Daru-Mau/ILMModule/Robotics & Design_ Localization module anthology/cover.tex

\begin{titlepage}
   \begin{center}
       
       % Logo centrale
       \begin{figure}[h]
       \begin{center}
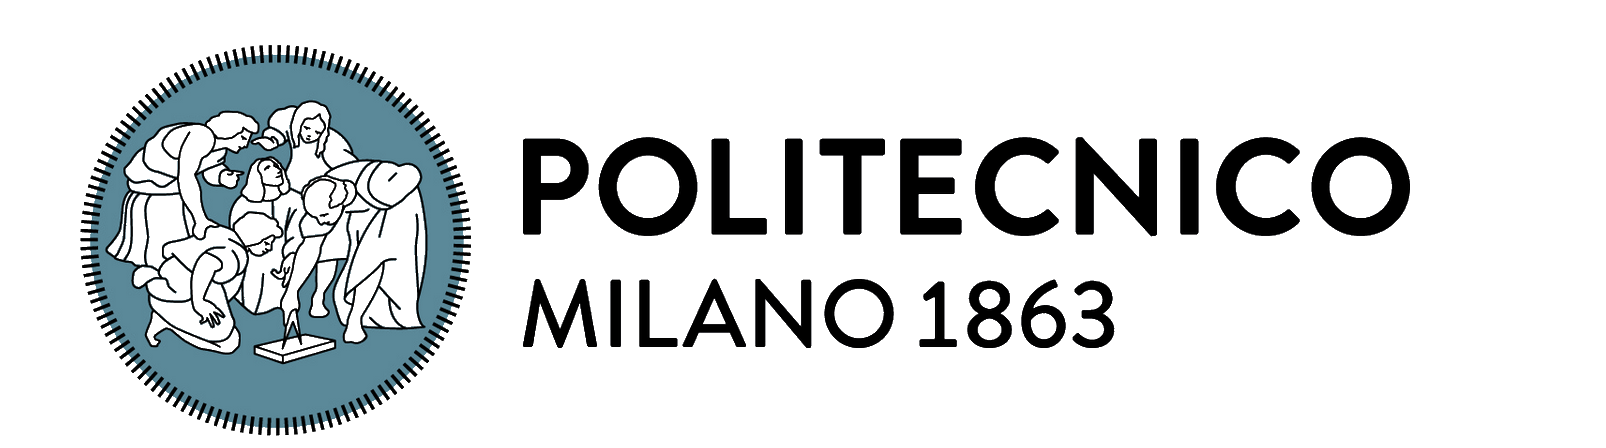
[picture p31: Robotics & Design_ Localization module anthology/photos/polimiLogo.png]
           
       \end{center}
       \end{figure}

       \vspace{0.5cm}
       
       {\large Interdisciplinary course of}
       
       \vspace{0.3cm}
       
       {\LARGE \textbf{Design and Robotics}}
       
       \vspace{0.3cm}
       
       {\large XIII° edition, 2025}
       
       \vspace{1.5cm}
       
       {\large Project:}
       
       \vspace{0.3cm}
       
       {\LARGE \textbf{Movement and Localization Module}}
       
       \vspace{2cm}
       
       % Professors and Tutors
       \begin{flushleft}
           {\large \textbf{Professors:}} \\
           Andrea Bonarini, DEIB department, Politecnico di Milano \\
           Maximiliano Romero, Design department, Politecnico di Milano \\
           \vspace{0.5cm}
           {\large \textbf{Tutors:}} \\
           Federico Espositi, Samuele Mengarelli, Niccolò Maria Oliva, Rohan Vangal \\
           \vspace{0.5cm}
           {\large \textbf{Group name/code:}} Movement and Localization \\
       \end{flushleft}
       
       \vspace{1cm}
       
       % Students
       \begin{flushleft}
           {\large \textbf{Students:}} \\
           Ermelinda Giulivo, School of Computer Science and Engineering \\
           Rafael Monllor Ballesteros, School of Industrial and Information Engineering \\
           Daniel Mauricio Ruiz Suarez, School of Computer Science and Engineering \\
           Jurij Diego Scandola, School of Computer Science and Engineering \\
           Abdul Moiz, School of Design and Industrial Engineering \\
           \vspace{1cm}
           \textbf{Academic Year:} 2024 - 2025 \\
       \end{flushleft}
   \end{center}

\end{titlepage}
