Daru-Mau/ILMModule/Robotics & Design_ Localization module anthology/main.tex

\documentclass{article}
\usepackage[utf8]{inputenc}
\usepackage{graphicx} 
\usepackage{import}
\usepackage{imakeidx} 
\usepackage{amsmath}
\usepackage{amssymb}
\usepackage{pdfpages}
\usepackage{array}
\usepackage{float} 
\usepackage{multicol}
\usepackage{listings} 
\usepackage{url}
\usepackage{csquotes}
\usepackage{caption}
\usepackage{xcolor}   
\usepackage{geometry}

\geometry{top=25mm, bottom=25mm, left=20mm, right=20mm}
\setlength{\parindent}{0pt}
\renewcommand\contentsname{Index}

\begin{document}

\import{./}{cover.tex}
\tableofcontents

% Abstract
\input{sections/abstract}

% Phase 1: Discover
\input{sections/phase1_discover}
\input{sections/movement_approach}
\input{sections/wheel_configurations}
\input{sections/robot_shape}
\input{sections/sensing_technology}

% Phase 2: Define
\input{sections/phase2_define}
\input{sections/strategy}
\input{sections/functionalities}
\input{sections/electronics}
\input{sections/coding}
\input{sections/structure}
\input{sections/shape}
\input{sections/concept}

% Phase 3: Develop
\input{sections/phase3_develop}
\input{sections/phase3_strategy}
\input{sections/phase3_electronics}
\input{sections/phase3_coding}
\input{sections/phase3_structure}
\input{sections/phase3_shape}

% Phase 4: Deliver
\input{sections/phase4_deliver}
\input{sections/phase4_robot_description}
\input{sections/phase4_strategy}
\input{sections/phase4_shape}
\input{sections/phase4_mechanics}
\input{sections/phase4_electronics}
\input{sections/phase4_informatics}

% Conclusion
\input{sections/conclusion}

% Appendix
\input{sections/appendix}

% Minutes of the Meetings
\input{sections/minutes}

% Bibliography
\input{sections/bibliography}

\end{document}
