Daru-Mau/ILMModule/Robotics & Design_ Localization module anthology/sections/phase3_develop.tex

\section{Phase 3: Develop}

In this phase we describe the development process, departing from the first prototype to the final improvements regarding strategy, electronics, coding, structure, and shape.
