Daru-Mau/ILMModule/Robotics & Design_ Localization module anthology/sections/prototypes.tex

\subsection{Group Cardboard Prototype Proposals}

When tasked with creating a cardboard prototype of the module, the group presented four different design proposals.

\subsubsection{Omnidirectional robot with four wheels positioned at the vertices of a square}
\textit{Proposed by: Ermelinda Giulivo}

\begin{figure}[H]
    \centering
    
    \caption{Four-wheel square configuration prototype}
\end{figure}

\subsubsection{Triangular-shaped, three-wheel omnidirectional robot}
\textit{Proposed by: Rafael Monllor Ballesteros}

\begin{figure}[H]
    \centering
    
    \caption{Triangular three-wheel configuration prototype}
\end{figure}

\subsubsection{Polygonal-shaped omnidirectional robot with four wheels arranged in a cross configuration}
\textit{Proposed by: Daniel Mauricio Ruiz Suarez}

\begin{figure}[H]
    \centering
    
    \caption{Polygonal cross-wheel configuration prototype}
\end{figure}

\subsubsection{Circular-shaped, three-wheel omnidirectional robot}
\textit{Proposed by: Jurij Diego Scandola}

\begin{figure}[H]
    \centering
    
    \caption{Circular three-wheel configuration prototype}
\end{figure}
