Daru-Mau/ILMModule/Robotics & Design_ Localization module anthology/sections/minutes.tex

\section{Minutes of the Meetings}

\subsection{Meeting: Project Kickoff}
\textbf{Date:} March 10, 2025\\
\textbf{Venue:} Politecnico di Milano, Bovisa Campus, Building B12, Room 5.1\\
\textbf{Attendees:} Ermelinda Giulivo, Rafael Monllor Ballesteros, Daniel Mauricio Ruiz Suarez, Jurij Diego Scandola, Abdul Moiz

\textbf{Topics Discussed:}
\begin{itemize}
    \item Introduction to project requirements and goals
    \item Team role assignments and responsibility distribution
    \item Initial brainstorming on robot concept and functionality
    \item Discussion of project timeline and key milestones
\end{itemize}

\textbf{Decisions:}
\begin{itemize}
    \item Selected Jurij Diego Scandola as team leader and backbone member
    \item Assigned specific roles to each team member
    \item Agreed to focus on an omnidirectional movement system
    \item Established weekly meeting schedule for progress updates
\end{itemize}

\subsection{Meeting: Design Phase Review}
\textbf{Date:} March 17, 2025\\
\textbf{Venue:} Virtual Meeting (Video Conference)\\
\textbf{Attendees:} Ermelinda Giulivo, Rafael Monllor Ballesteros, Daniel Mauricio Ruiz Suarez, Jurij Diego Scandola, Abdul Moiz

\textbf{Topics Discussed:}
\begin{itemize}
    \item Review of initial research findings
    \item Presentation and evaluation of different wheel configuration options
    \item Comparison of sensor technologies for obstacle detection
    \item Discussion of aesthetic concepts and physical form
\end{itemize}

\textbf{Decisions:}
\begin{itemize}
    \item Selected three-wheel omnidirectional configuration
    \item Chose ultrasonic sensors as primary obstacle detection method
    \item Approved "cooking pot" aesthetic concept with cloud-like base
    \item Assigned team members to begin component procurement
\end{itemize}

\subsection{Meeting: Development Phase Coordination}
\textbf{Date:} April 7, 2025\\
\textbf{Venue:} Politecnico di Milano, Bovisa Campus, Prototyping Lab\\
\textbf{Attendees:} Ermelinda Giulivo, Rafael Monllor Ballesteros, Daniel Mauricio Ruiz Suarez, Jurij Diego Scandola, Abdul Moiz

\textbf{Topics Discussed:}
\begin{itemize}
    \item Progress update on physical structure construction
    \item Review of electronics configuration and wiring plan
    \item Discussion of software architecture and control algorithms
    \item Timeline adjustment for remaining development tasks
\end{itemize}

\textbf{Decisions:}
\begin{itemize}
    \item Modified structural design to remove intermediate platform
    \item Approved motor driver selection and power distribution approach
    \item Established coding standards and module interfaces
    \item Adjusted timeline to allow more time for integration testing
\end{itemize}

\subsection{Meeting: Final Integration and Testing}
\textbf{Date:} May 12, 2025\\
\textbf{Venue:} Politecnico di Milano, Bovisa Campus, Robotics Lab\\
\textbf{Attendees:} Ermelinda Giulivo, Rafael Monllor Ballesteros, Daniel Mauricio Ruiz Suarez, Jurij Diego Scandola, Abdul Moiz

\textbf{Topics Discussed:}
\begin{itemize}
    \item Integration status of all subsystems
    \item Test results and performance metrics
    \item Remaining issues and troubleshooting
    \item Final presentation preparation
\end{itemize}

\textbf{Decisions:}
\begin{itemize}
    \item Implemented additional stabilization code for smoother movement
    \item Added LED lighting effects to enhance visual appeal
    \item Assigned final documentation responsibilities
    \item Scheduled rehearsal for final presentation
\end{itemize}

\subsection{Meeting: Project Wrap-up}
\textbf{Date:} May 29, 2025\\
\textbf{Venue:} Virtual Meeting (Video Conference)\\
\textbf{Attendees:} Ermelinda Giulivo, Rafael Monllor Ballesteros, Daniel Mauricio Ruiz Suarez, Jurij Diego Scandola, Abdul Moiz

\textbf{Topics Discussed:}
\begin{itemize}
    \item Final project status and demonstration readiness
    \item Report completion and review
    \item Lessons learned and project retrospective
    \item Future improvement possibilities
\end{itemize}

\textbf{Decisions:}
\begin{itemize}
    \item Finalized demonstration script and responsibility assignments
    \item Approved final report for submission
    \item Agreed on project archiving process for documentation and code
    \item Discussed potential extensions for future project iterations
\end{itemize}
