Daru-Mau/ILMModule/Robotics & Design_ Localization module anthology/photos/2.jpg

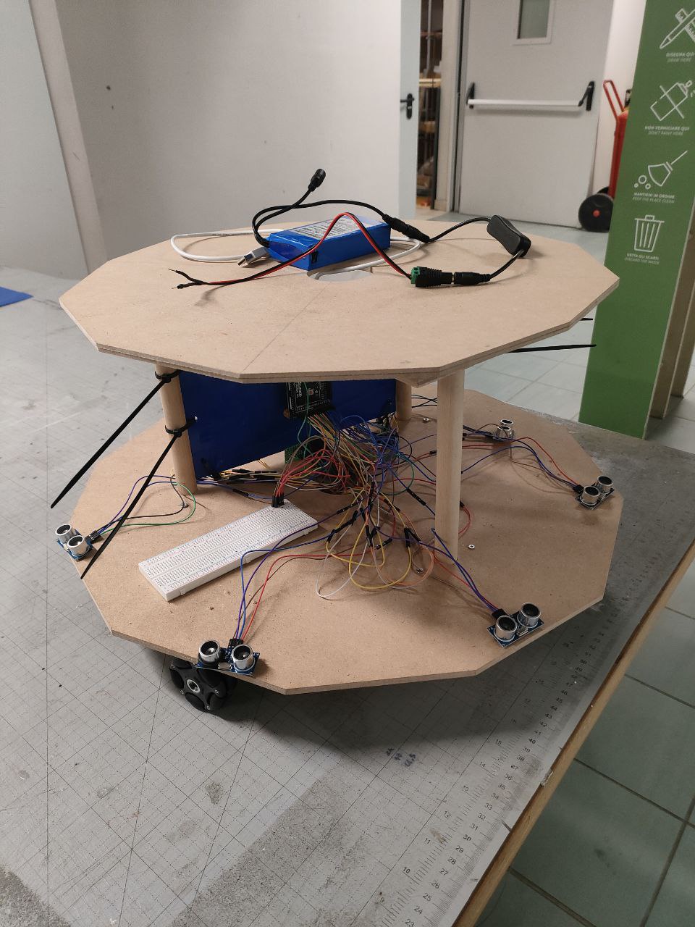
Robotics & Design_ Localization module anthology/photos/2.jpg
