Daru-Mau/ILMModule/Robotics & Design_ Localization module anthology/photos/4.jpg

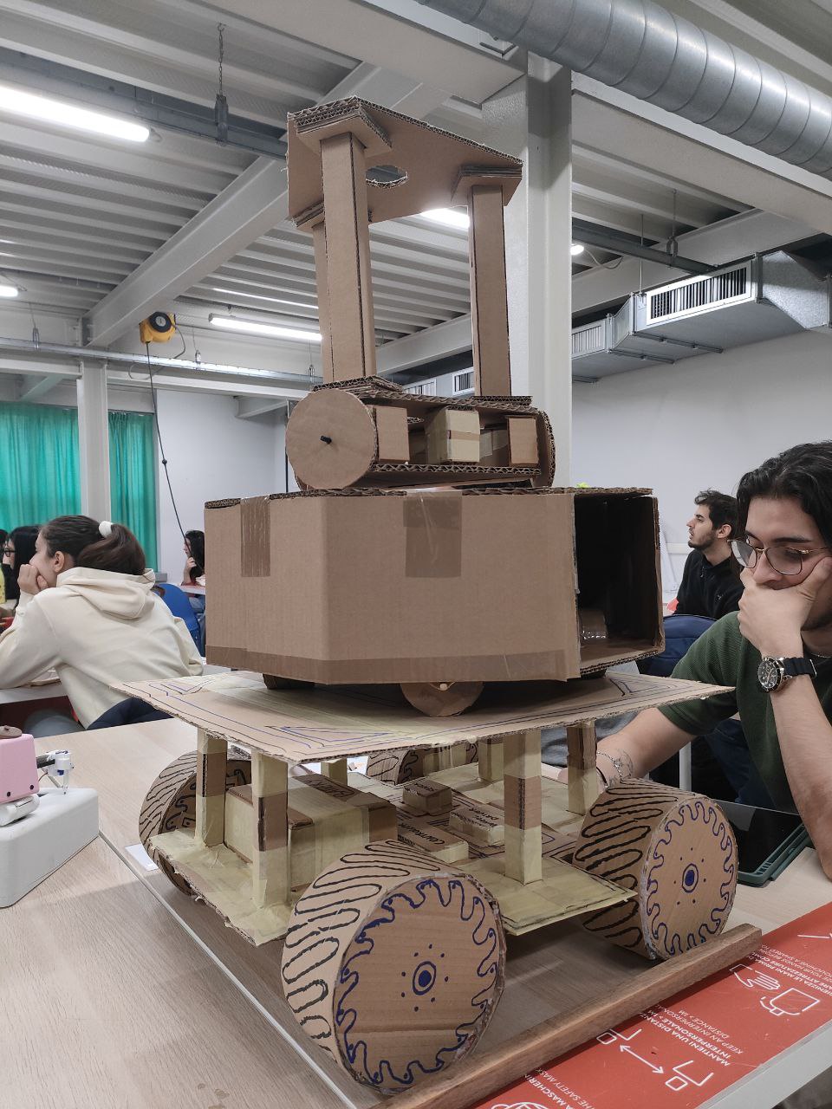
Robotics & Design_ Localization module anthology/photos/4.jpg
