Daru-Mau/ILMModule/Robotics & Design_ Localization module anthology/photos/5.jpg

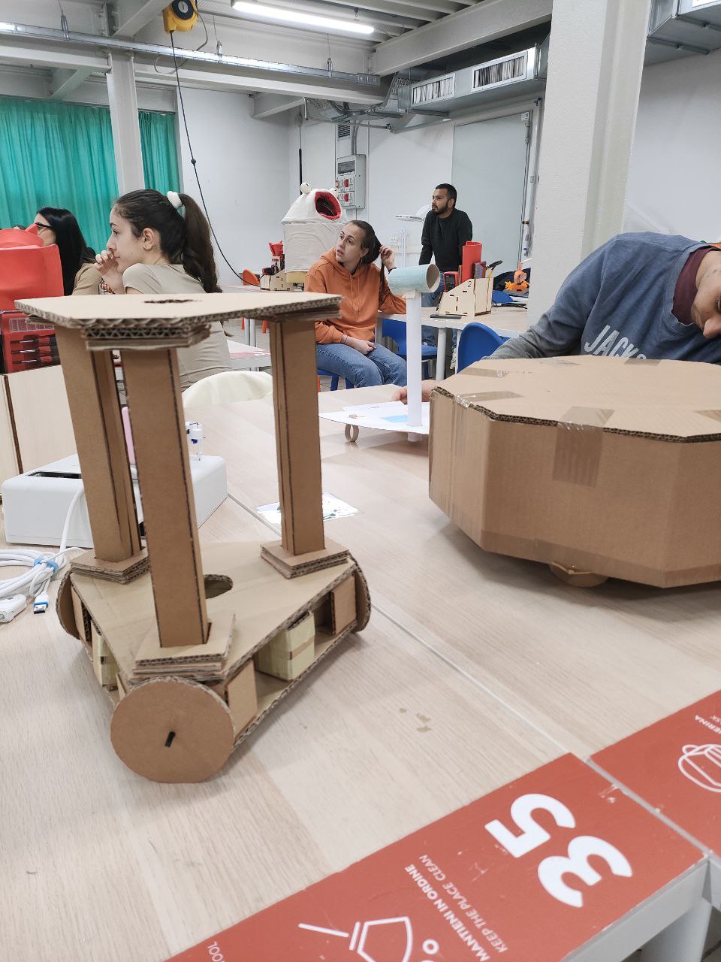
Robotics & Design_ Localization module anthology/photos/5.jpg
