Daru-Mau/ILMModule/Robotics & Design_ Localization module anthology/photos/6.jpg

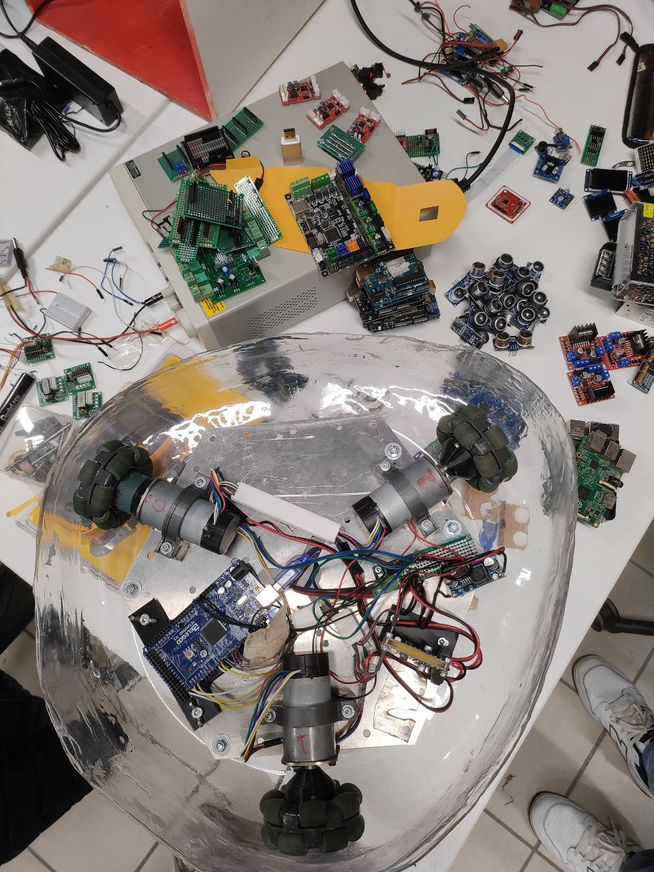
Robotics & Design_ Localization module anthology/photos/6.jpg
