Daru-Mau/ILMModule/Robotics & Design_ Localization module anthology/photos/8.jpg

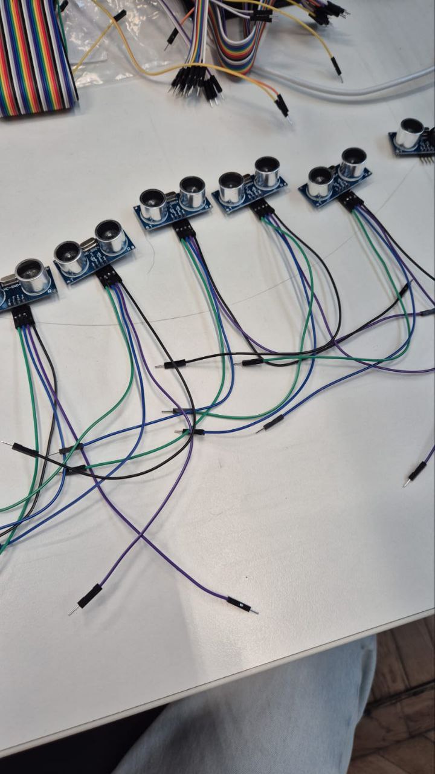
Robotics & Design_ Localization module anthology/photos/8.jpg
