Daru-Mau/ILMModule/Robotics & Design_ Localization module anthology/photos/10.jpg

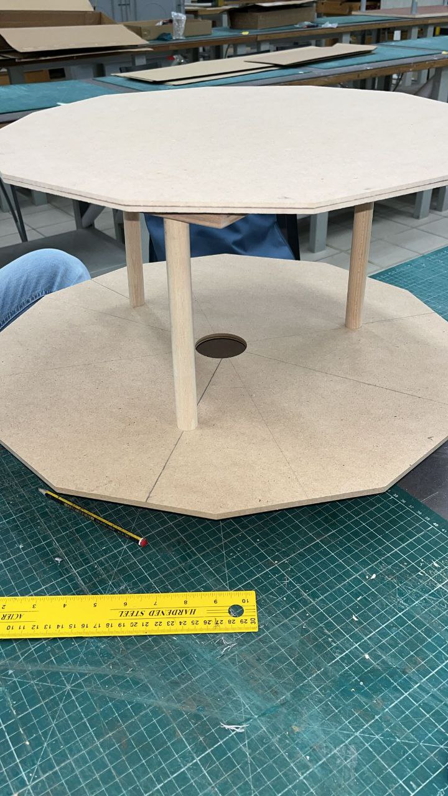
Robotics & Design_ Localization module anthology/photos/10.jpg
