Daru-Mau/ILMModule/Robotics & Design_ Localization module anthology/photos/dani_fixing_fixed.jpg

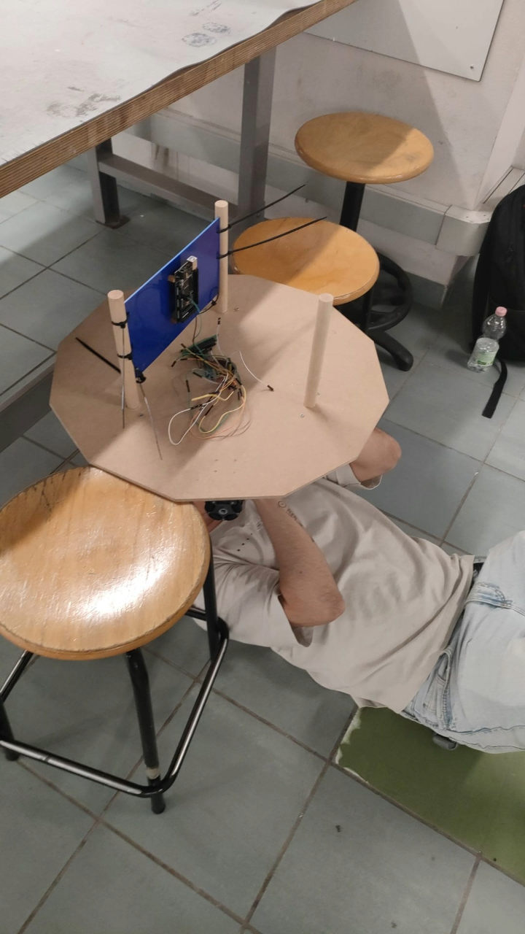
Robotics & Design_ Localization module anthology/photos/dani_fixing_fixed.jpg
