Daru-Mau/ILMModule/Robotics & Design_ Localization module anthology/photos/dc motor.jpg

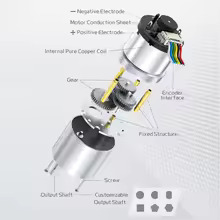
Robotics & Design_ Localization module anthology/photos/dc motor.jpg
