Daru-Mau/ILMModule/Robotics & Design_ Localization module anthology/photos/dc-motor-diagram.jpg

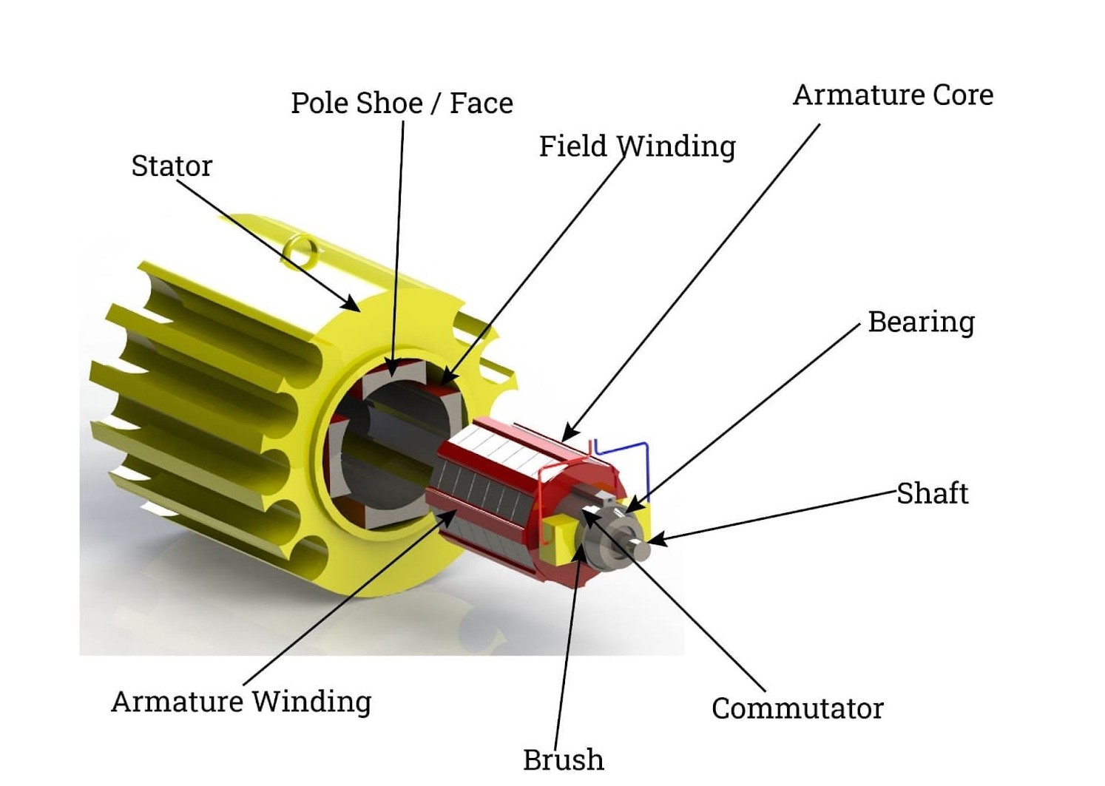
Robotics & Design_ Localization module anthology/photos/dc-motor-diagram.jpg
