Daru-Mau/ILMModule/Robotics & Design_ Localization module anthology/photos/omnirob.png

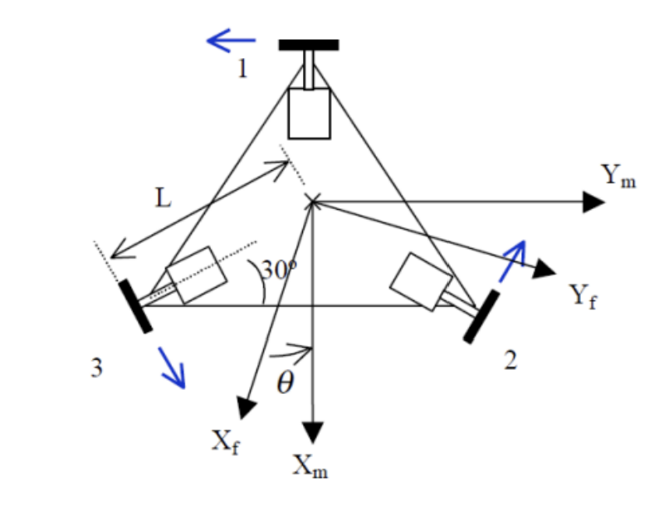
Robotics & Design_ Localization module anthology/photos/omnirob.png
