Daru-Mau/ILMModule/Robotics & Design_ Localization module anthology/photos/wheel.jpg

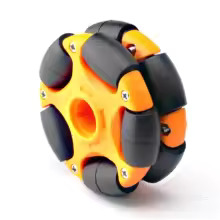
Robotics & Design_ Localization module anthology/photos/wheel.jpg
