Daru-Mau/ILMModule/camera_captures/test_capture_1747831809.jpg

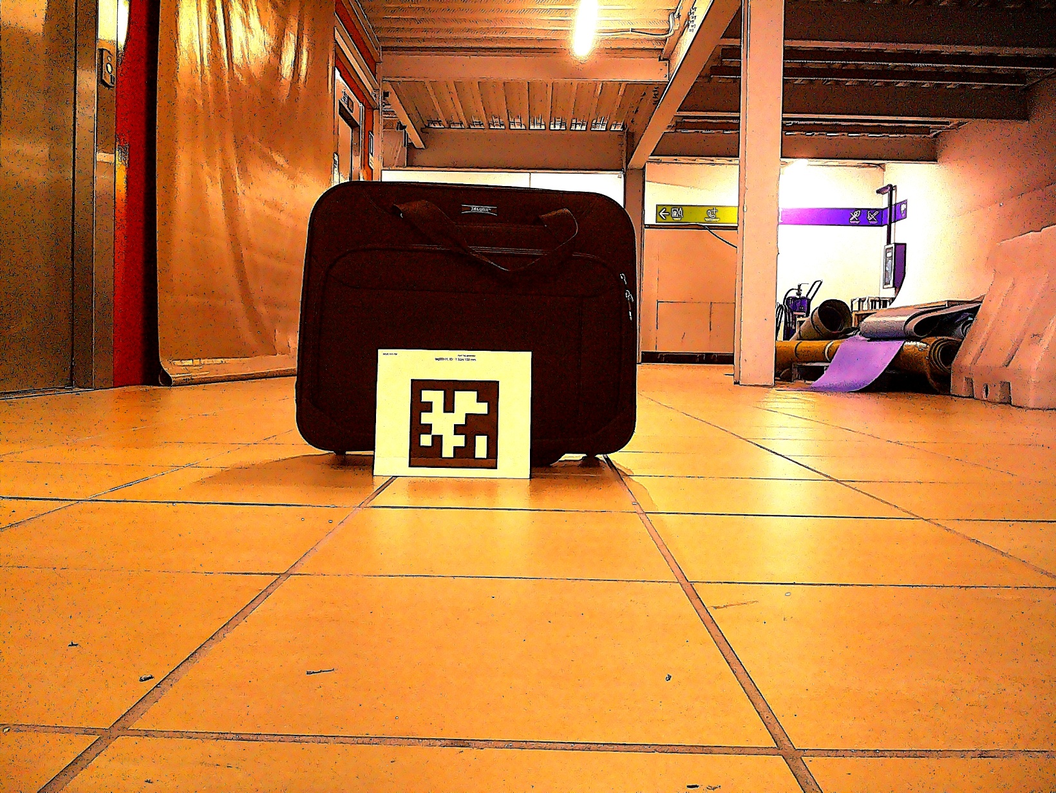
camera_captures/test_capture_1747831809.jpg
