Daru-Mau/ILMModule/camera_captures/test_capture_1747832399.jpg

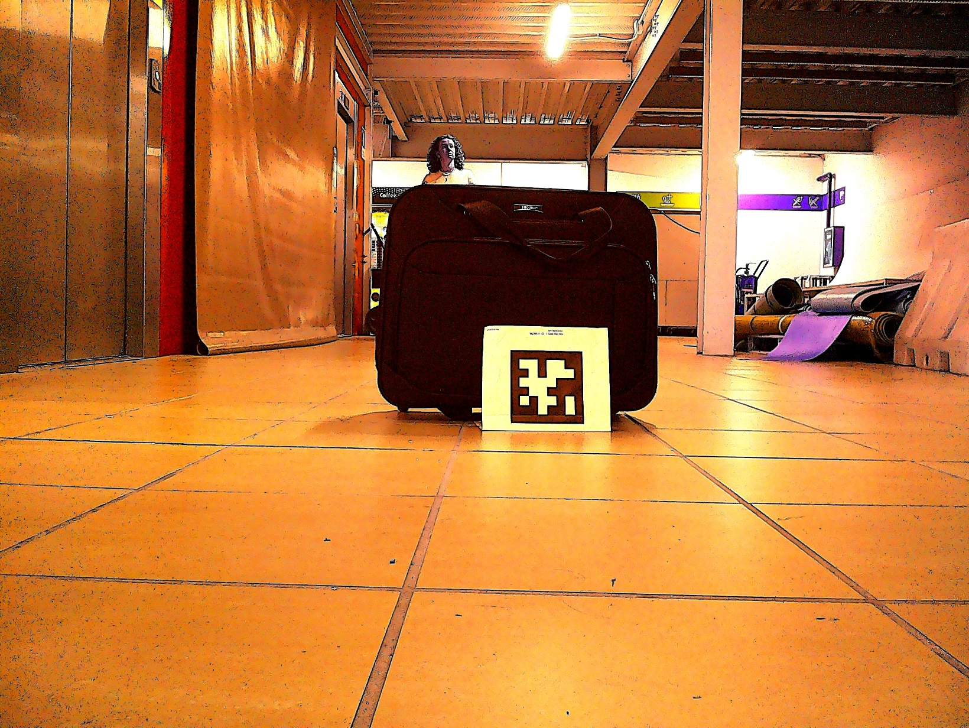
camera_captures/test_capture_1747832399.jpg
