Daru-Mau/ILMModule/camera_captures/debug_gray_1747832400.jpg

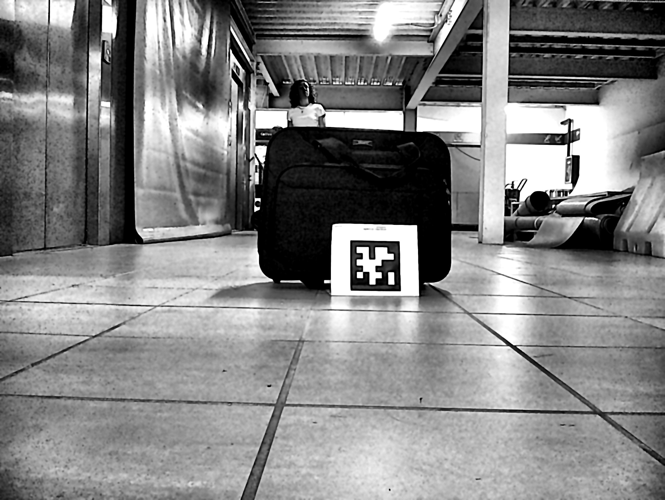
camera_captures/debug_gray_1747832400.jpg
