Daru-Mau/ILMModule/(commit log)

2025-04-26 Implementación del sistema de localización mejorado para robot Arduino, integrando sensores de encoders, IMU y detecciones de AprilTag.
2025-04-28 Añadir código básico para la prueba de motores en Arduino
2025-04-28 Añadir archivo de prueba para sensores ultrasónicos
2025-04-29 Add main table of contents for Robotics & Design Localization module
    - Introduced a comprehensive table of contents (TOC) for the anthology, covering sections from introduction to final considerations.
    - Included subsections detailing functionalities, design considerations, materials, electronics, software, testing, and future improvements.
    - Enhanced navigation and structure for better readability and accessibility of the document.
2025-04-29 Remove obsolete motor and ultrasonic sensor testing code; restructure motor testing implementation for improved functionality and clarity.
2025-04-29 Fix rear ultrasonic sensor pin definitions to correct values
    [Testing_Sensors.ino]
2025-04-29 Refactor motor control implementation and update pin definitions for improved clarity and functionality
2025-05-01 Refactor testing section in documentation and enhance movement control in firmware
    - Updated the testing section in the main document to include detailed methodologies, results, and limitations.
    - Added subsections for sensor and motor testing, integration testing results, and system performance metrics.
    - Introduced new sections for possible future improvements and testing conclusions with specific achievements and lessons learned.
    - Enhanced the Arduino firmware for the robot's movement control, implementing dynamic speed adjustments based on distance readings.
    - Added emergency stop functionality and refined motor control logic for smoother operation.
    - Included comprehensive comments and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
2025-05-01 Fix camera configuration size and rotate captured frames for correct orientation
2025-05-01 Update camera configuration size for improved image processing
2025-05-04 Add Flask web server for AprilTag camera feed and implement frame streaming
2025-05-04 Implement Arduino communication handler for AprilTag recognition system
2025-05-04 Enhance AprilTag recognition performance by optimizing camera settings, improving image preprocessing, and adjusting robot control parameters for better navigation accuracy.
2025-05-04 Refactor AprilTag recognition system: update camera configuration, enhance HTML interface, and remove cloud deployment support
2025-05-04 Refactor AprilTag recognition system: optimize camera settings, enhance performance, and simplify HTML interface
2025-05-04 Enhance robot software architecture and AprilTag communication
    - Added a new section in the main document detailing the software architecture, including system overview, communication protocol, control modes, implementation details, performance characteristics, and safety features.
    - Updated `apriltag_communication.py` to improve Arduino communication, including sending tag data and position updates, and added methods for clearing tag data and reading responses.
    - Refactored `apriltag_recognition.py` to streamline AprilTag detection and processing, integrating camera calibration and enhancing communication with Arduino.
    - Updated `requirements.txt` to specify compatible versions for dependen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
2025-05-05 Refactor AprilTag recognition code for improved structure and performance; integrate serial communication and enhance web interface for Raspberry Pi 4 compatibility
2025-05-06 Enhance AprilTag recognition system: optimize camera settings, improve frame processing, and implement graceful shutdown handling
2025-05-07 Refactor AprilTag recognition and camera test scripts for improved performance and usability
    - Optimized AprilTag recognition system for better tag detection and navigation without video streaming features.
    - Enhanced camera setup with improved configuration for Raspberry Pi, including better exposure and gain settings.
    - Removed Flask web server from AprilTag recognition script, focusing on command display mode.
    - Added command line argument support to camera test script for direct display mode or web streaming.
    - Implemented robust error handling and logging in camera test script to manage camera initialization and frame capture.
    - Improved frame processing and detection confidence handlin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
    [apriltag_communication.py]
2025-05-07 Add integrated movement controller combining AprilTag tracking and obstacle avoidance
    [integrated_movement.ino]
2025-05-07 Enhance camera configuration and AprilTag recognition parameters for improved detection accuracy and performance
2025-05-12 Refactor ultrasonic sensor pin definitions for improved clarity and organization
2025-05-12 Arduino IDE installation
2025-05-12 Add function declarations for AprilTagController and enable Arduino communication
2025-05-13 Refactor motor pin definitions and adjust speed settings across multiple files for consistency; enhance serial communication initialization and debugging features in Arduino communication scripts.
2025-05-13 Enhance motor test script with interactive serial control mode; remove obsolete serial test script
2025-05-13 Update motor speed settings and add command for dynamic speed adjustment; modify serial port configuration
2025-05-13 Fix formatting issues in basic_moveset.ino and update default port comment in motor_test.py for clarity
    [basic_moveset.ino, motor_test.py]
2025-05-16 Refactor Arduino communication module and integrate motor test scripts
    - Renamed `apriltag_communication` to `communication_test` for clarity.
    - Created a new `communication_test.py` module to handle Arduino communication with improved logging and command structure.
    - Developed `integrated_motor_test.py` for comprehensive motor testing, including automated and interactive modes.
    - Introduced `raspy_communication.py` as a centralized communication interface for better maintainability and code reuse.
    - Enhanced command handling with retry logic and command statistics tracking.
    - Updated logging format for better readability and debugging.
    - Added detailed docstrings and comments for better cod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
2025-05-16 Update motor pin configurations and add movement control logic for new motor arrangement - cww setting cause real left motor is giving problems
    [basic_moveset.ino, integrated_movement.ino]
2025-05-19 Refactor integrated movement code to enhance sensor data handling and improve error checking; add comprehensive sensor format testing script and update monitoring scripts for better performance and r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
    [integrated_movement.ino, integrated_sensor_test.py, monitor_sensor_data.py, monitor_sensor_data_fixed.py, quick_arduino_test.py, test_sensor_format.py]
2025-05-19 Refactor integrated movement and sensor testing scripts; update motor pin configurations and enhance error checking in compilation scripts for improved reliability and performance.
    [Testing_Sensors.ino, integrated_movement.ino]
2025-05-19 Refactor UART communication module and add comprehensive documentation
    - Deleted obsolete `raspy_communication_ccw.py` file.
    - Created `UART_COMMUNICATION_GUIDE.md` to provide detailed instructions on using the UART communication module for Raspberry Pi and Arduino integration.
    - Added `debug_movement_test.py` script for enhanced logging and debugging of movement commands via UART.
    - Implemented `test_uart_communication.py` for testing UART communication with interactive and automated modes.
    - Developed `uart_communication.py` module to handle UART communication with improved reliability, including automatic port detection, command retry logic, and detailed connection statistics.
2025-05-19 Add comprehensive UART communication documentation and migration helper scripts
2025-05-19 Refactor AprilTag recognition system to utilize UART communication; update imports, enhance serial setup, and improve direction handling with standardized codes. Add comprehensive documentation for U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
2025-05-19 Add comprehensive Arduino communication and sensor monitoring scripts
    - Introduced `monitor_sensor_data.py` for monitoring sensor data from Arduino.
    - Added `quick_arduino_test.py` for basic Arduino communication testing.
    - Implemented `raspy_communication.py` for centralized communication with Arduino.
    - Created `run_sensor_tests.sh` to automate a series of tests for Arduino integration.
    - Developed `simple_verify.sh` for straightforward Arduino code verification.
    - Added `test_sensor_format.py` to validate the format of sensor data packets.
    - Implemented `verify_arduino_code.sh` for checking Arduino code compilation.
    - Removed obsolete files related to previous implementations.
2025-05-19 feat: Add enhanced motor test script with dynamic control and diagnostics
    - Introduced a new motor test script (motor_test_temp.py) for the ILM module.
    - Implemented automated motor tests and dynamic velocity control.
    - Added support for both 2-wheel and 3-wheel modes.
    - Included direct serial communication and compatibility with Arduino firmware.
    - Enhanced interactive mode for real-time control and feedback.
    - Added comprehensive testing functions for individual motors and movement patterns.
    - Implemented diagnostics command to verify Arduino connection and functionality.
    chore: Create upgrade script for motor_test.py
    - Developed an upgrade script (update_motor_test.py) to automate the a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
2025-05-20 refactor: Update motor test script settings and improve method structure
2025-05-20 Enhance AprilTagUARTController and UART communication
    - Added dynamic speed calculation based on distance to target in AprilTagUARTController.
    - Refactored direction and speed determination into a single method.
    - Improved logging for distance, direction, and speed.
    - Streamlined UART communication by removing unused functions and simplifying command sending.
    - Updated TagData to include speed instead of distance.
    - Adjusted send_movement method to handle speed constraints and direction codes.
    - Removed unnecessary comments and legacy code for clarity.
2025-05-20 feat: Add ultrasonic distance reading and update speed parameters in UART controller
2025-05-20 refactor: Update integrated movement controller and UART communication for improved motor control and distance handling
2025-05-20 feat: Add support for three-wheel configuration in AprilTag UART controller
    - Updated AprilTagUARTController to include a new parameter for three-wheel mode.
    - Enhanced UARTCommunicator to handle wheel mode switching.
    - Created a comprehensive Wheel Configuration Guide to explain usage and differences between two-wheel and three-wheel modes.
    - Implemented a test script for validating wheel configuration functionality.
    - Improved logging for better debugging and tracking of wheel mode changes.
2025-05-21 feat: Enhance movement functions with 3-wheel support and improved mode switching
2025-05-21 feat: Implement integrated movement controller for AprilTag simulation with UART communication
2025-05-21 feat: Update speed parameters for integrated movement controller and UART communication
2025-05-21 feat: Implement I2C communication and master override functionality for movement control
    How It Works:
    When Master Takes Control:
    Master can send an 'S' command over I2C or set pin 13 HIGH
    Arduino immediately stops all motors and ignores serial commands
    DEBUG_MODE will show "<MASTER_OVERRIDE_ACTIVE>" periodically
    When Master Releases Control:
    Master sends an 'R' command or sets pin 13 LOW
    Arduino resumes normal operations
    Status Reporting:
    Arduino will report status to master when requested
    'A' for active, 'S' for suspended, 'E' for emergency stop
    This implementation provides two ways for the master Arduino to control this slave: via I2C commands or via a direct pin connection. Both metho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
2025-05-21 fix: Update motor control pin definitions for left wheel and adjust master override pin configuration
    [basic_moveset.ino, integrated_movement.ino]
2025-05-22 refactor: Improve readability of speed parameter validation in UART communication
2025-05-22 refactor: Update motor control command inputs and improve interactive mode command descriptions
2025-05-22 refactor: Update default distance and direction inputs in motor test script for consistency
2025-05-22 refactor: Update motor command descriptions and fix command mappings in motor test script
    [basic_moveset.ino, integrated_movement.ino, motor_test.py]
2025-05-22 refactor: Update motor control definitions and streamline movement functions for improved clarity and functionality
2025-05-23 refactor: Update movement command handling and motor definitions for consistency and clarity - Working Movement
2025-05-23 refactor: Update motor pin definitions and enhance dynamic speed calculations for safety and clarity
2025-05-23 refactor: Enhance motor control logic and speed constraints for smoother transitions and safety
2025-05-23 Remove obsolete test scripts for UART communication, wheel configuration, and motor testing. These scripts are no longer needed as functionality has been integrated into other components or replaced 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
    [debug_movement_test.py, integrated_motor_test.py, integrated_movement.ino, integrated_sensor_test.py, migrate_to_uart.py, monitor_sensor_data.py, quick_arduino_test.py, raspy_communication.py]
2025-05-26 Implement enhanced movement system with dynamic speed control, obstacle avoidance, and communication support
    [fine_moveset_enhanced.ino]
2025-05-26 refactor: Revise I2C communication setup and command handling for improved clarity and functionality
2025-05-26 refactor: Enhance debug mode functionality in Arduino communication and motor test scripts
2025-05-26 refactor: Adjust motor control logic in turn functions for improved maneuverability
2025-05-26 refactor: Clean up code formatting and improve readability in integrated movement and AprilTag UART controller
2025-05-27 feat: Add NeoPixel LED effects and configuration for enhanced visual feedback
2025-05-27 feat: Implement advanced obstacle avoidance logic with state management and dynamic navigation
    [integrated_movement.ino, obstacle_avoidance.ino]
2025-05-27 feat: Add NeoPixel LED control functionality with dynamic effects and configuration
2025-05-27 Add example sketches and support for various NeoPixel configurations
    - Introduced simple example sketch for NeoPixel ring control.
    - Added example using dynamic memory allocation with the "new" operator.
    - Implemented a comprehensive strand test example for various lighting effects.
    - Created a non-blocking strand test example to demonstrate efficient pixel control.
    - Added a wheel effect example for smooth color transitions.
    - Implemented K210 specific pixel control functionality.
    - Updated keywords for syntax highlighting in the library.
    - Enhanced library properties with versioning and author information.
    - Added RP2040 PIO support for optimized NeoPixel control.
2025-05-27 feat: Enhance obstacle avoidance functionality with new helper functions and improved state management
    [integrated_movement.ino, obstacle_avoidance.ino]
2025-05-27 feat: Refactor obstacle avoidance logic for improved clarity and efficiency - No Compile Errors
    [integrated_movement.ino, obstacle_avoidance.ino]
2025-05-27 feat: Implement smooth deceleration functionality for improved motor control and safety - Compiling
2025-05-31 Enhance smooth deceleration system and troubleshooting documentation
    - Updated motor control system to include direction preservation during smooth acceleration and deceleration.
    - Introduced a new section detailing the smooth deceleration system, including challenges and solutions.
    - Added code snippets for direction tracking and smooth deceleration implementation.
    - Improved testing phase documentation to reflect integration challenges and design refinements.
    - Created a comprehensive troubleshooting guide addressing common issues, including undefined references and movement control problems.
    - Ensured proper extern declarations for global direction variables to resolve compilation errors.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
2025-06-08 Refactor and enhance Localization and Movement Module (ILMModule)
    - Updated README.md to reflect new module name and added features including I2C coordination and six distinct movement types.
    - Removed TROUBLESHOOTING.md as it was no longer relevant.
    - Deleted outdated motor and sensor testing sketches from Testing_Motors and Testing_Sensors directories.
    - Added comprehensive UART communication guide and integration summary.
    - Implemented new launch script for AprilTag controller with improved speed parameters.
    - Enhanced uart_communication.py with extended direction codes and convenience methods for movement commands.
    - Integrated I2C communication capabilities for master coordination.
    - Im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
    [Testing_Motors.ino, Testing_Sensors.ino, integrated_movement.ino, launch_apriltag_controller.py, uart_communication.py]
2025-06-08 chore: Remove IMU integration references from README for clarity
2025-06-08 Add initial sections for the movement module of a mobile social robot
    - Created abstract section detailing the design and implementation of the movement module.
    - Added coding section outlining core functionalities and programming approach using C++ and Arduino.
    - Introduced concept section explaining the robot's purpose as a social assistant in a university setting.
    - Developed electronics section describing the components and their integration for precise motor control and sensing.
    - Defined functionalities of the movement module, including patrolling, user interaction, and charging behavior.
    - Elaborated on the omnidirectional movement approach, highlighting advantages and limitations.
    -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
2025-06-08 Add comprehensive documentation and finalize robot design for presentation
    - Created bibliography section with relevant references for the project.
    - Developed a detailed conclusion summarizing project achievements and future work.
    - Compiled minutes from project meetings to document team discussions and decisions.
    - Documented coding phase, outlining control system implementation and testing.
    - Detailed electronics setup, including component descriptions and wiring diagrams.
    - Described the physical structure of the robot, including design adaptations and assembly process.
    - Finalized the robot's aesthetic design, emphasizing character-driven elements.
    - Outlined the strategy for project de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
